stash-s/vfd-clock/doc/using-shift-out-closeup.png

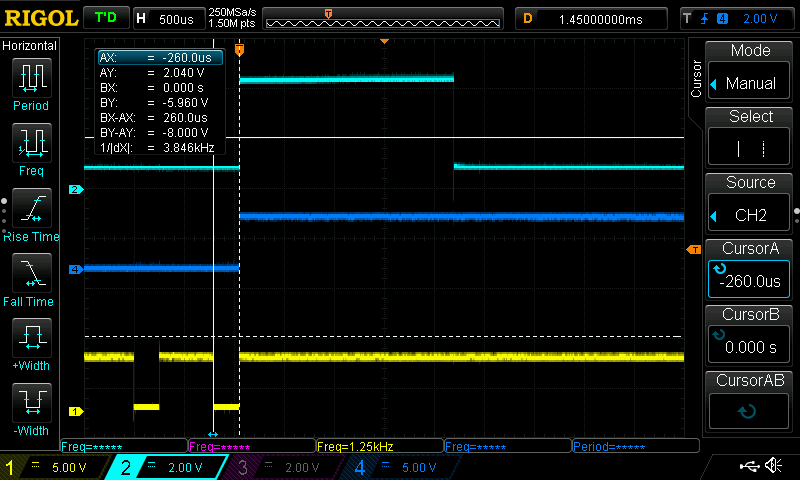
doc/using-shift-out-closeup.png
