stash-s/vfd-clock/doc/using-shift-out.png

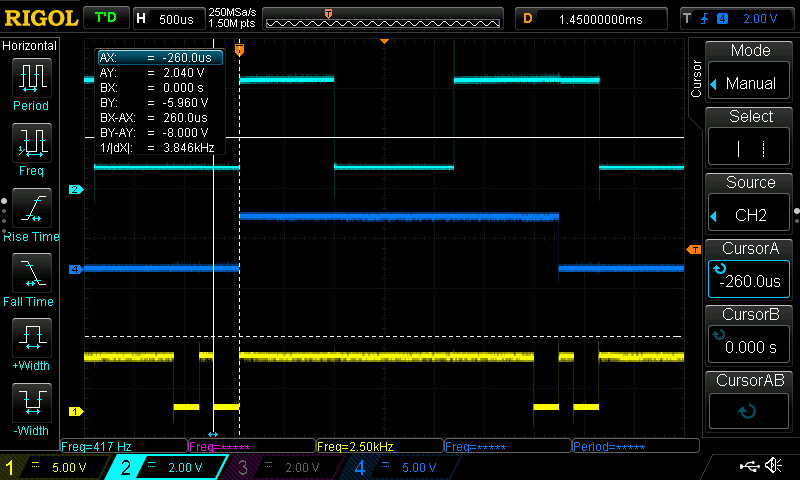
doc/using-shift-out.png
