stash-s/vfd-clock/doc/using-spi-2.png

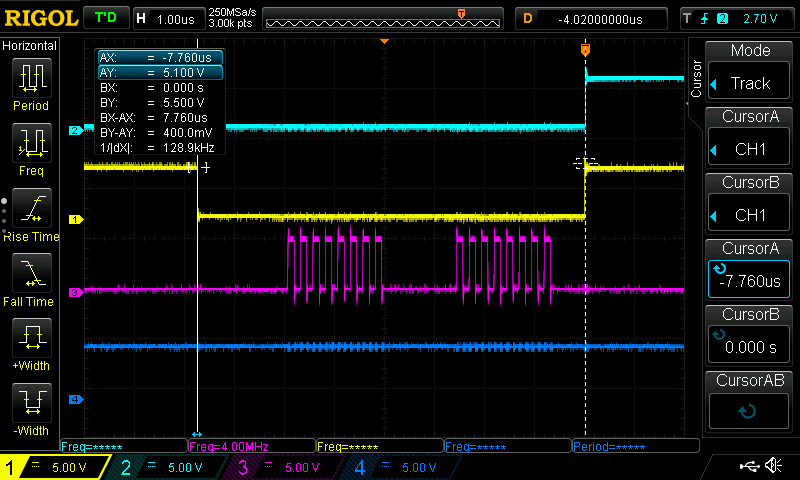
doc/using-spi-2.png
