stash-s/vfd-clock/doc/using-spi-macro.png

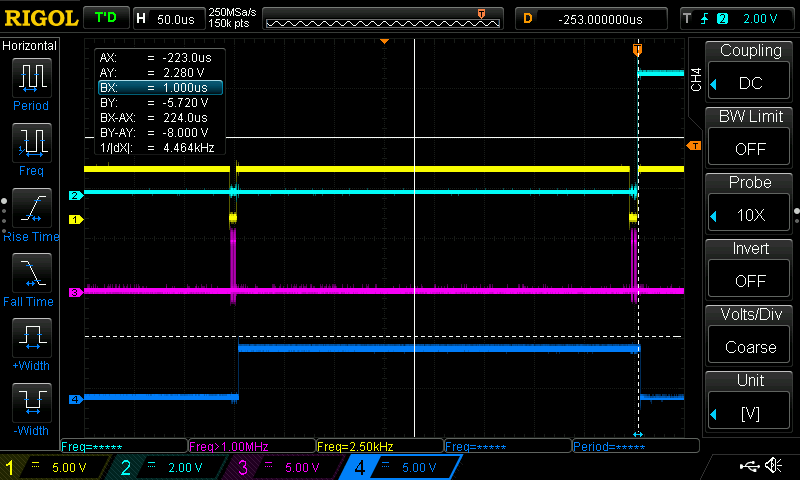
doc/using-spi-macro.png
