stash-s/vfd-clock/doc/using-spi.png

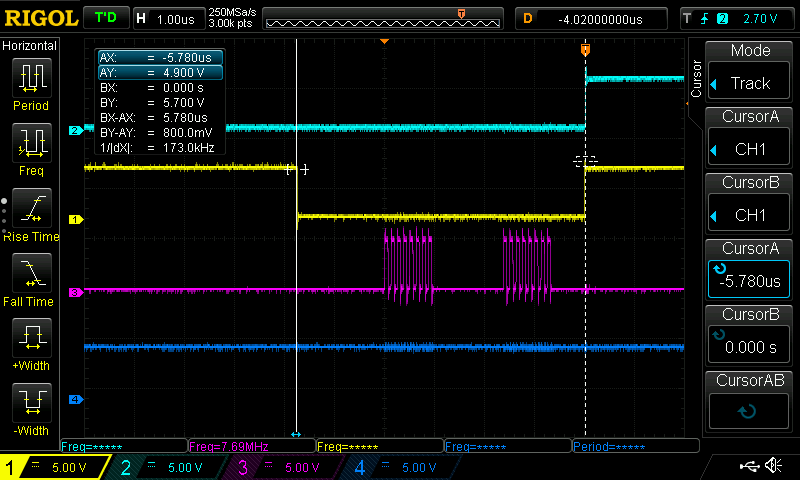
doc/using-spi.png
