stash-s/vfd-clock/eagle/mainboard.brd

## EAGLE design eagle/mainboard.brd (2018-02-26)

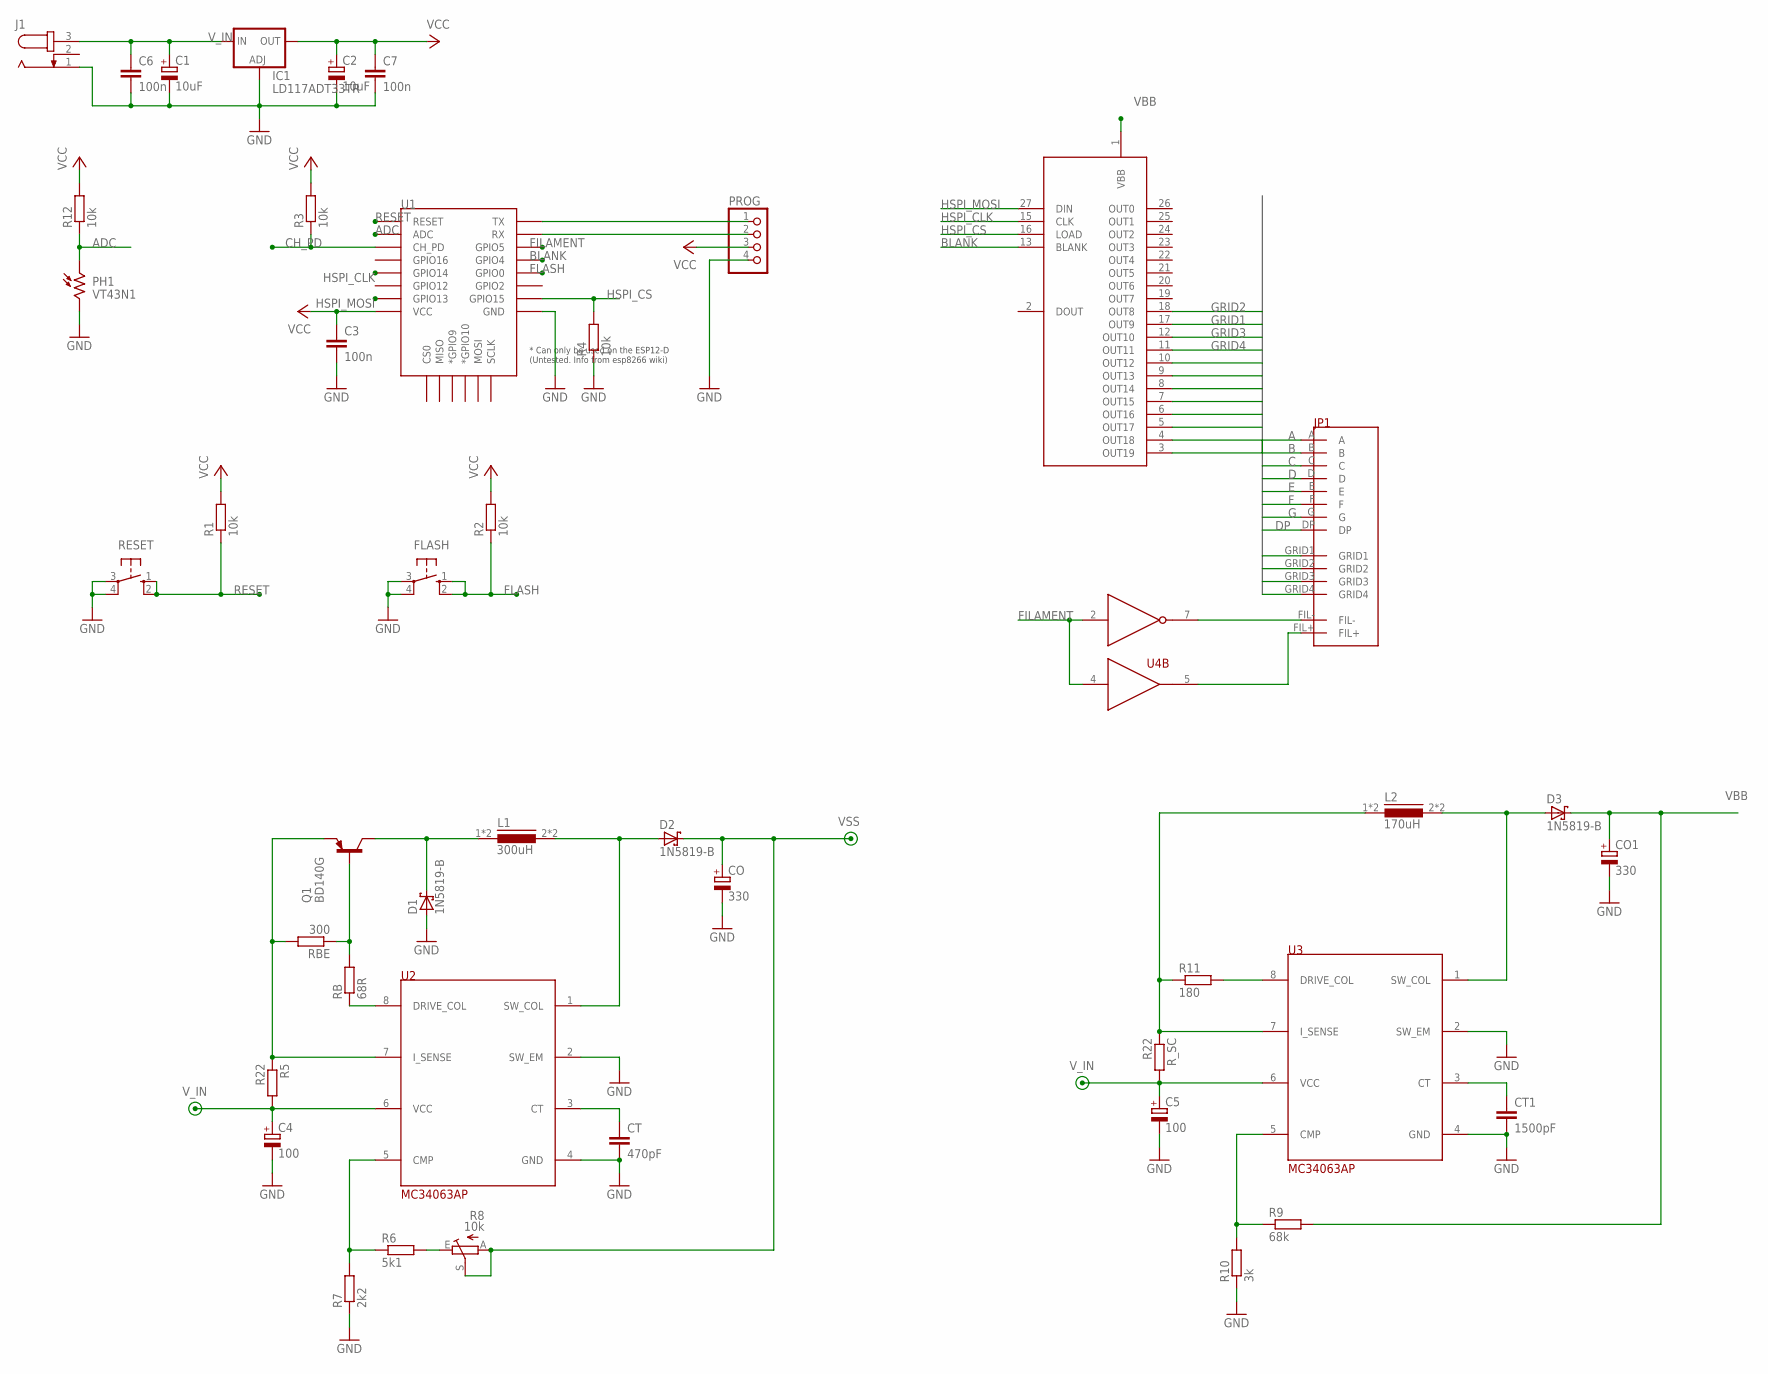
[picture p6: schematic mainboard.sch]

Parts:
C1, C2: 10uF; TT2D5L
C3, C6, C7: 100n; C050-024X044
C4, C5: 100; TT2D5L
CO: 330; TT5D11R
CO1: 330; TT5D11L
CT: 470pF; C025-025X050
CT1: 1500pF; C025-025X050
D1, D2, D3: 1N5819-B; DO41-7.6
FLASH: 10-XX; B3F-10XX
IC1: LD117ADT33TR; DPACK
J1: JACK-PLUG0; SPC4077
JP1: PINHD-2X102X10-MALE; 2X10
L1: 300uH; TOROID
L2: 170uH; TOROID
PH1: VT43N1; VT400
PROG: PINHD-1X4/90; 1X04/90
Q1: BD140G; TO225AA
R1, R12: 10k; 0207/15
R2, R4: 10k; 0204/7
R3: 10k; 0207/10
R5: R22; 0411/15
R6: 5k1; 0204/7
R7: 2k2; 0204/7
R8: 10k; S64W
R9: 68k; 0204/7
R10: 3k; 0204/7
R11: 180; 0204/7
RB: 68R; 0204/7
RBE: 300; 0204/7
RESET: 10-XX; B3F-10XX
R_SC: R22; 0411/15
U1: ESP12ESMD; ESP12E-SMD
U2, U3: MC34063AP; DIL8
U4: MAX628; DIL8
U$1: MAX6921AWI; SOP28X

Connections:
A: JP1.A, U$1.10 (OUT12)
ADC: PH1.1, R12.1, U1.ADC
B: JP1.B, U$1.9 (OUT13)
BLANK: U1.GPIO4, U$1.13 (BLANK)
C: JP1.C, U$1.8 (OUT14)
CH_PD: R3.1, U1.CH_PD
D: JP1.D, U$1.7 (OUT15)
DP: JP1.DP, U$1.3 (OUT19)
E: JP1.E, U$1.6 (OUT16)
F: JP1.F, U$1.5 (OUT17)
FIL+: JP1.FIL+, U4.5 (OUT)
FIL-: JP1.FIL-, U4.7 (OUT)
FILAMENT: U1.GPIO5, U4.2 (IN), U4.4 (IN)
FLASH: FLASH.1 (S), FLASH.2 (S1), R2.1, U1.GPIO0
G: JP1.G, U$1.4 (OUT18)
GND: C1.-, C2.-, C3.2, C4.-, C5.-, C6.2, C7.2, CO.-, CO1.-, CT.2, CT1.2, D1.A, FLASH.3, FLASH.4 (P1), IC1.1 (ADJ), J1.1, PH1.2, PROG.4, R4.1, R7.1, R10.1, RESET.3, RESET.4 (P1), U1.GND, U2.2 (SW_EM), U2.4 (GND), U3.2 (SW_EM), U3.4 (GND), U4.3 (GND), U$1.14 (GND)
GRID1: JP1.GRID1, U$1.17 (OUT9)
GRID2: JP1.GRID2, U$1.18 (OUT8)
GRID3: JP1.GRID3, U$1.12 (OUT10)
GRID4: JP1.GRID4, U$1.11 (OUT11)
HSPI_CLK: U1.GPIO14, U$1.15 (CLK)
HSPI_CS: R4.2, U1.GPIO15, U$1.16 (LOAD)
HSPI_MOSI: U1.GPIO13, U$1.27 (DIN)
unnamed: Q1.3 (B), RB.2, RBE.1
unnamed: RB.1, U2.8 (DRIVE_COL)
unnamed: Q1.1 (E), R5.1, RBE.2, U2.7 (I_SENSE)
unnamed: D2.A, L1.2, L1.2A (2), U2.1 (SW_COL)
unnamed: D1.C, L1.1, L1.1A (1), Q1.2 (C)
unnamed: CT.1, U2.3 (CT)
unnamed: R6.1, R7.2, U2.5 (CMP)
unnamed: R6.2, R8.E
unnamed: L2.1, L2.1A (1), R11.1, R_SC.1, U3.7 (I_SENSE)
unnamed: D3.A, L2.2, L2.2A (2), U3.1 (SW_COL)
unnamed: CT1.1, U3.3 (CT)
unnamed: R9.1, R10.2, U3.5 (CMP)
unnamed: R11.2, U3.8 (DRIVE_COL)
RESET: R1.1, RESET.1 (S), RESET.2 (S1), U1.RESET
RX: PROG.2, U1.RXD0 (RX)
TX: PROG.1, U1.TXD0 (TX)
VBB: CO1.+, D3.C, R9.2, U$1.1 (VBB)
VCC: C2.+, C3.1, C7.1, IC1.4 (OUT), PROG.3, R1.2, R2.2, R3.2, R12.2, U1.VCC, U$1.28 (VCC)
VSS: CO.+, D2.C, R8.A, R8.S, U4.6 (VSS)
V_IN: C1.+, C4.+, C5.+, C6.1, IC1.3 (IN), J1.3, R5.2, R_SC.2, U2.6 (VCC), U3.6 (VCC)

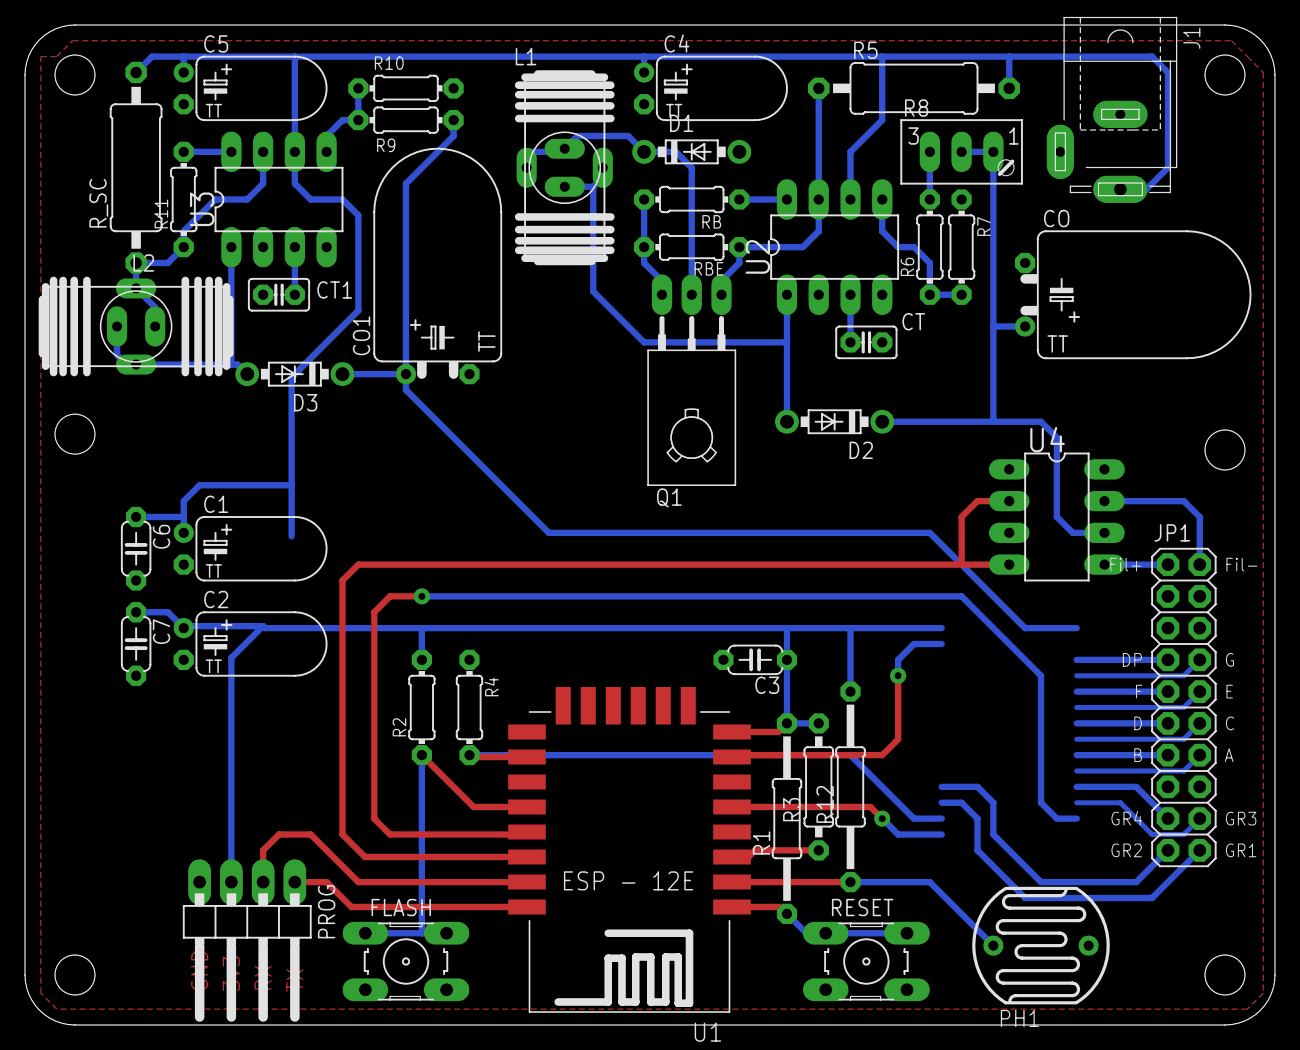
[picture p7: board mainboard.brd from above]

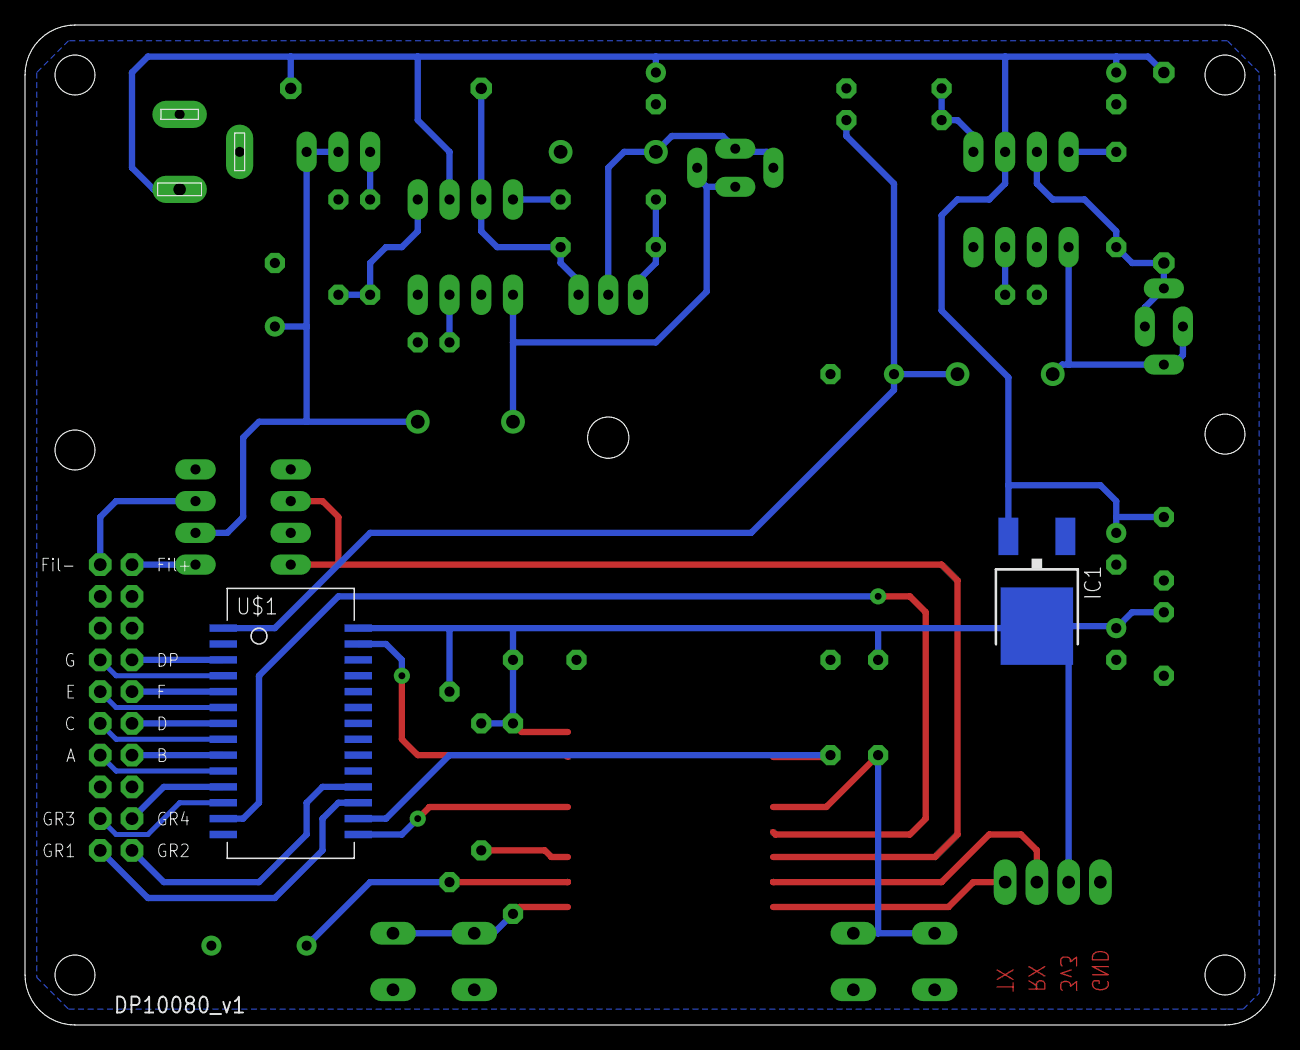
[picture p8: board mainboard.brd from below]

Board: 2 copper layers, 100.0 x 80.0 mm, 45 parts (2 on the bottom side), 43 nets.

Other parts of the board:
U$3: DP10080_V1
