stash-s/vfd-clock/eagle/lamps.brd

## EAGLE design eagle/lamps.brd (2018-02-26)

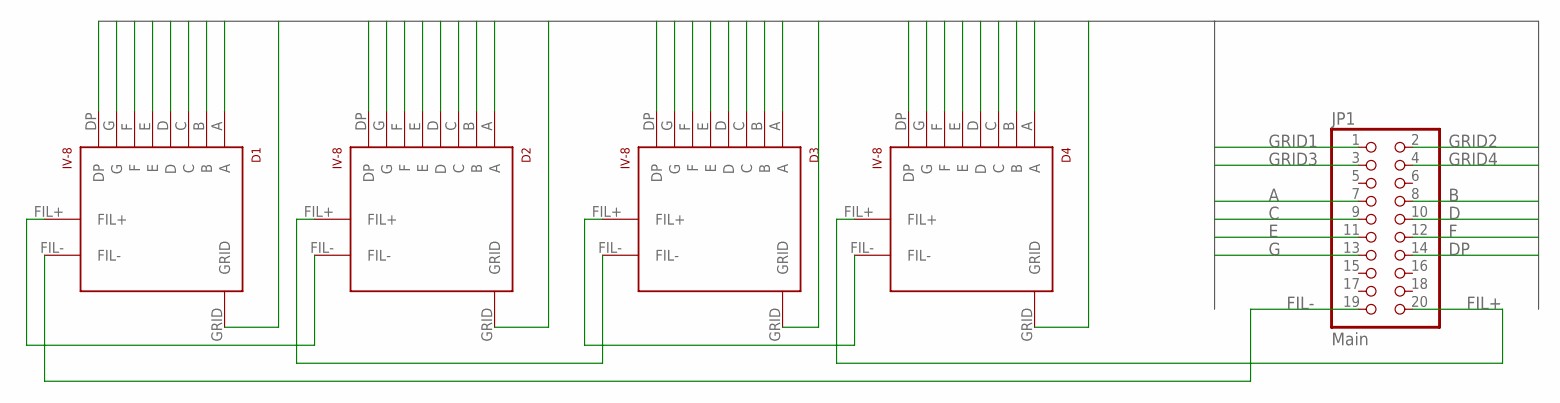
[picture p9: schematic lamps.sch]

Parts:
D1, D2, D3, D4: IV-8
JP1: Main; 2X10

Connections:
A: D1.A, D2.A, D3.A, D4.A, JP1.7 (A)
B: D1.B, D2.B, D3.B, D4.B, JP1.8 (B)
C: D1.C, D2.C, D3.C, D4.C, JP1.9 (C)
D: D1.D, D2.D, D3.D, D4.D, JP1.10 (D)
DP: D1.DP, D2.DP, D3.DP, D4.DP, JP1.14 (DP)
E: D1.E, D2.E, D3.E, D4.E, JP1.11 (E)
F: D1.F, D2.F, D3.F, D4.F, JP1.12 (F)
FIL+: D4.FIL+, JP1.20 (FIL+)
FIL-: D1.FIL-, JP1.19 (FIL-)
G: D1.G, D2.G, D3.G, D4.G, JP1.13 (G)
GRID1: D1.GRID, JP1.1 (GRID1)
GRID2: D2.GRID, JP1.2 (GRID2)
GRID3: D3.GRID, JP1.3 (GRID3)
GRID4: D4.GRID, JP1.4 (GRID4)
unnamed: D2.FIL+, D3.FIL-
unnamed: D1.FIL+, D2.FIL-
unnamed: D3.FIL+, D4.FIL-

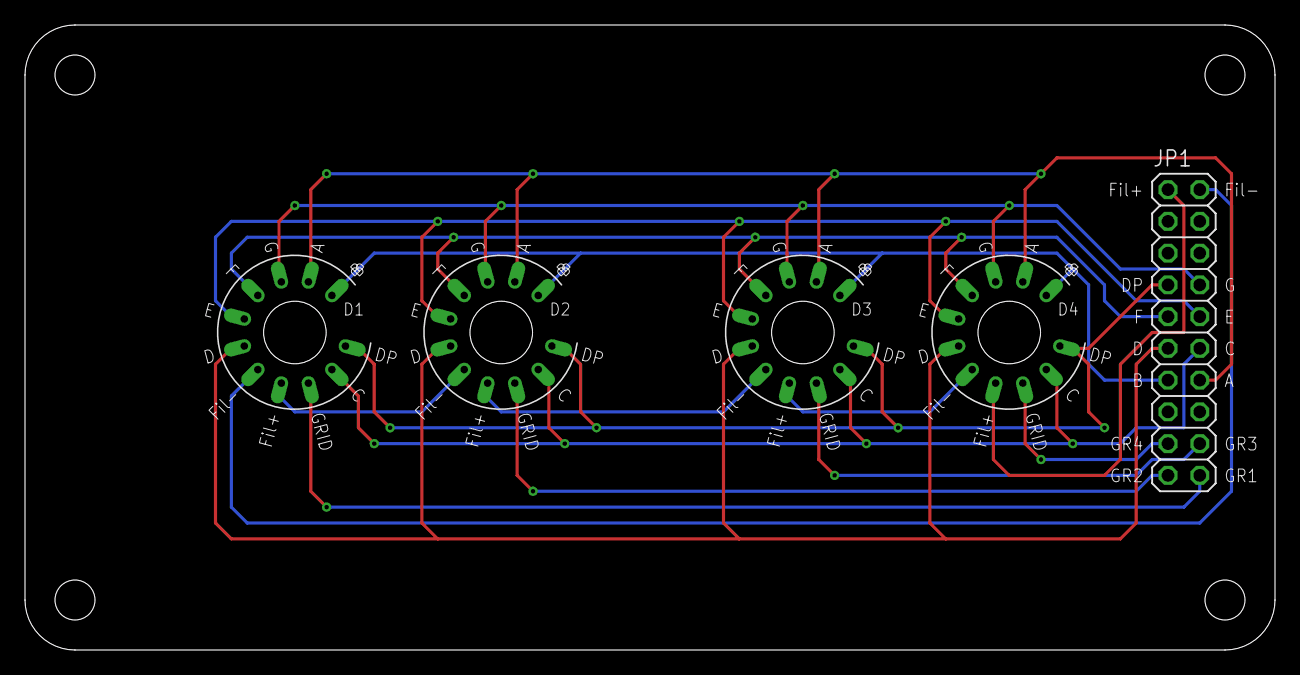
[picture p10: board lamps.brd from above]

Board: 2 copper layers, 100.0 x 50.0 mm, 6 parts (0 on the bottom side), 17 nets.

Other parts of the board:
U$1: DP10050_V1
