stash-s/vfd-clock/(commit log)

2017-10-22 Main VFD driver loop works off AVR ISR call.
2017-10-22 Set pulled up 74HC595 MR pin to zero after bootup. Pulling pin up at boot time prevents constantly lit grids.
    [blink.ino]
2017-11-01 adding filament pin PWM control
2017-11-25 Replaced loooong portable shiftOut calls with SPI
    [blink.ino]
2017-11-26 Added doc screenshots of SPI vs. generic shiftOut.
2018-02-26 Mainboard ready for printing.
    [lamps-manual.brd, lamps-manual.sch, lamps.brd, lamps.sch, mainboard.brd, mainboard.sch]
